NOBIC-NTU/NOBIC-SCELSE-Preamplifier/README.md

# NOBIC-SCELSE-Preamplifier
Public repository for fixed gain transimpedance amplifier circuit for two-photon microscopes
