NOBIC-NTU/NOBIC-SCELSE-Preamplifier/Bill of Materials/Final Bill of Materials v1r4 Assembly exclude active components.xlsx

Designator | Footprint | LibRef | Desc | Cmmt | Pins | THT(y/n) | Tolerance | Rating | Value | Quantity | Manufacturer | Manufacturer Part No
C1, C3 | RES-0603 | - CAP-NON | SMT Chip Capacitor | - | 2 | N | 10% | 20V | 1uF | 1 | Samsung Electro-Mechanics | CL10B105KA8NFNC (https://www.mouser.sg/ProductDetail/Samsung-Electro-Mechanics/CL10B105KA8NFNC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)
C2, C5 | CAP-0603 | - CAP-NON | SMT Chip Capacitor | - | 2 | N | 20% | 10V | 22uF | 2 | Murata | GRM188R61A226ME15D (https://www.mouser.sg/ProductDetail/Murata-Electronics/GRM188R61A226ME15D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)
C4 | RES-0603 | - CAP-NON | SMT Chip Capacitor | - | 2 | N | 10% | 16V | 4.7uF | 1 | Samsung Electro-Mechanics | CL10A475MO8NNNC (https://www.mouser.sg/ProductDetail/Samsung-Electro-Mechanics/CL10A475MO8NNNC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)
C6, C15 | CAP-0603 | - CAP-NON | Multilayer Ceramic Capacitors MLCC - SMD/SMT | - | 2 | N | ±0.1pF | 50V | 0.75pF | 2 | Walsin | RF18NR75B500CT (https://www.mouser.sg/ProductDetail/Walsin/RF18NR75B500CT?qs=hzBznG4dWXWSuJqhmXrjQw%3D%3D)
C7, C16 | CAP-0603 | - CAP-NON | Multilayer Ceramic Capacitors MLCC - SMD/SMT | - | 2 | N | ±1% | 100V | 13pF | 2 | Murata | GCM1885C2A130FA16J (https://www.mouser.sg/ProductDetail/Murata-Electronics/GCM1885C2A130FA16J?qs=QzBtWTOodeVdB%252BMy5RRu7A%3D%3D)
C8, C10, C17, C19, C9, C11, C18, C20 | RES-0603 | - CAP-NON | SMT Chip Capacitor | - | 2 | N | 5% | 10V | 0.1uF | 8 | Samsung Electro-Mechanics | CL10B104JB8NNNC (https://www.mouser.sg/ProductDetail/Samsung-Electro-Mechanics/CL10B104JB8NNNC?qs=349EhDEZ59oLEw5wc1qvGw%3D%3D)
C12, C13, C14, C21, C22, C23 | CAP-0603 | - CAP-NON | Multilayer Ceramic Capacitors MLCC - SMD/SMT | DNP | 2 | N | ±1% | 25V |  | 6
CNR2, CNR4, CNR6, CNR8 | SMA_EDGE | SMA | RF Connectors / Coaxial Connectors SMA PCB MOUNT JACK | DNP | 2 |  |  |  |  | 4 | Taoglas | EMPCB.SMAFSTJ.C.HT (https://www.mouser.sg/ProductDetail/Taoglas/EMPCB.SMAFSTJ.C.HT?qs=AL7xPqYNrmS49k5WLHoXWA%3D%3D)
CP1 | SME8x10.5-2.2E [E] | - CAP-POL | Aluminium Electrolytic Capacitors - SMD 63 Volts 10uF | - | 2 | N | 20% | 20V | 10uF | 1 | United Chemi-Con | EMVH630ADA100MH63G (https://www.mouser.sg/ProductDetail/United-Chemi-Con/EMVH630ADA100MH63G?qs=pW%2FnNqOvN%2FD4nZo4A7r8EQ%3D%3D)
D1 | SOD123 | - DIO-ZNR | Schottky Diodes & Rectifiers REC SPCL SKTKY | - | 2 | N | - | 0.5A | 20 V | 1 | onsemi | SBR80520LT1G (https://www.mouser.sg/ProductDetail/onsemi/SBR80520LT1G?qs=VZpK7o2ExSQ%252BUJtVfeZ3AQ%3D%3D)
FB1, FB2, FB3, FB4, FB5, FB6 | IND-0603 | - IND | Ferrite Beads 60 OHM 25% | - | 2 | N | 25% | 0.6A | 60 Ohms @ 100MHz | 6 | Murata | BLM18BB600SN1D (https://www.mouser.sg/ProductDetail/Murata-Electronics/BLM18BB600SN1D?qs=O%252B3PzI9Hd0PHjaZtQ%252BJmbQ%3D%3D)
FB3, FB4, FB5, FB6 | IND-0603 | - IND | 0 ohm Jumpers | DNP | 2 | N | 25% | 0.6A | 0R | 0 | Vishay | CRCW06030000Z0EBC (https://www.mouser.sg/ProductDetail/Vishay-Dale/CRCW06030000Z0EBC?qs=wd5RIQLrsJgQzOqdcVum5Q%3D%3D)
L1, L2 | IND-0805[NL] | - IND | Fixed Inductors 0805 4.7uH .265Ohms +/-20%Tol 700mA | - | 2 | N | 20% | 500mA | 4.7uH | 2 | Taiyo Yuden | BRC2012T4R7MD (https://www.mouser.sg/ProductDetail/Taiyo-Yuden/BRC2012T4R7MD?qs=I6KAKw0tg2xBb7myNzjo4A%3D%3D)
R1, R7 | RES-0603 | - RES-FIX | Thick Film Resistors - SMD 28.7K ohm 1% | - | 2 | N | ±1% | 50V | 28.7K | 2 | Bourns | CR0603-FX-2872ELF (https://www.mouser.sg/ProductDetail/Bourns/CR0603-FX-2872ELF?qs=I4suiNu8FYAnWpr1IIimOQ%3D%3D)
R2, R8 | RES-0603 | - RES-FIX | Thick Film Resistors - SMD 287Ohms 1/10W 0603 1% AEC-Q200 | - | 2 | N | ±1% | 50V | 287R | 2 | Yageo | AC0603FR-07287RL (https://www.mouser.sg/ProductDetail/YAGEO/AC0603FR-07287RL?qs=ygRr%2FtkhteusAISpE4WOKw%3D%3D)
R3, R5, R6, R9, R11, R12 | RES-0603 | - RES-FIX | - | DNP | 2 | N | ±1% | 50V |  | 6
R4, R10 | RES-0603 | - RES-FIX | Thick Film Resistors - SMD 33 Ohms 100mW 0603 1% | - | 2 | N | ±1% | 50V | 33R | 2 | Yageo | RC0603FR-0733RL (https://www.mouser.sg/ProductDetail/YAGEO/RC0603FR-0733RL?qs=diQw95jMAeMotgif2GSHTQ%3D%3D)
R13 | RES-0603 | - RES-FIX | Thin Film Resistors 9.88kOhm,0603,0.1%,25ppm,125mW,75V | - | 2 | N | ±0.1% | 75V | 9.88k | 1 | Vishay | TNPW06039K88BEEA (https://www.mouser.sg/ProductDetail/Vishay-Dale/TNPW06039K88BEEA?qs=xRzy8zN3RW08B1d9kgF3Jg%3D%3D)
R14 | RES-0603 | - RES-FIX | Thin Film Resistors - SMD 10K ohm 0.5% 1/10W | - | 2 | N | ±1% | 50V | 10k | 1 | YAGEO | RT0603DRE0710KL (https://www.mouser.sg/ProductDetail/YAGEO/RT0603DRE0710KL?qs=8cPjvKtxWv4b6IDhFsneiQ%3D%3D)
TVS1, TVS2 | SOD923F | - TVS-UNI | ESD Suppressors / TVS Diodes SOD-923 ESD PROT | - | 2 | N | - | 140W | 12V | 2 | onsemi | ESD9X12ST5G (https://www.mouser.sg/ProductDetail/onsemi/ESD9X12ST5G?qs=OSf9jACorvYeEtLjAfCdrQ%3D%3D)
U1 | SOT223 | > ICS: LDL1117SxxR | LDO Voltage Regulators 1.2 A High PSRR low dropout linear voltage regulator | DNP | 4 | N | - | - | - | 1 | STMicroelectronics | LDL1117S25R (https://www.mouser.sg/ProductDetail/STMicroelectronics/LDL1117S25R?qs=AQlKX63v8Rvz10Qjkk6upg%3D%3D)
U2 | SOT95P280X145-5N | REG: LT1611CS5#TRMPBF | Switching Voltage Regulators 1.4MHz Inverting Sw Reg. | DNP | 5 | N | - | - | - | 1 | Analog Devices | LT1611CS5#TRMPBF (https://www.mouser.sg/ProductDetail/Analog-Devices/LT1611CS5TRMPBF?qs=ytflclh7QUWyKl6o%2Fr0zng%3D%3D)
U3, U4 | SON50P300X300X80-11N-D | > ICS: LTC6269IDD#PBF | 500MHz Ultra-Low Bias Current FET Input Op Amp | DNP | 11 | N | - | - | - | 2 | AD | LTC6269IDD#PBF (https://www.mouser.sg/ProductDetail/Analog-Devices/LTC6269IDDPBF?qs=hVkxg5c3xu8tgdvxZL9h5w%3D%3D)
CNR1, 3, 5, 7, 9 |  |  | Headers & Wire Housings 2mm Pitch WtoB Conn 2pos Straight Header | DNP | 2 | Y |  |  |  | 5 | Hirose | DF51K-2P-2DSA(800) (https://www.mouser.sg/ProductDetail/Hirose-Connector/DF51K-2P-2DSA800?qs=T3oQrply3y%2FMgopKRZYGOg%3D%3D)
