NOBIC-NTU/NOBIC-SCELSE-Preamplifier/3D Models/Board dimensions and Hirose conns No components/TIA_v1r4_July2022_VerticalConns_FlipPWR.stp

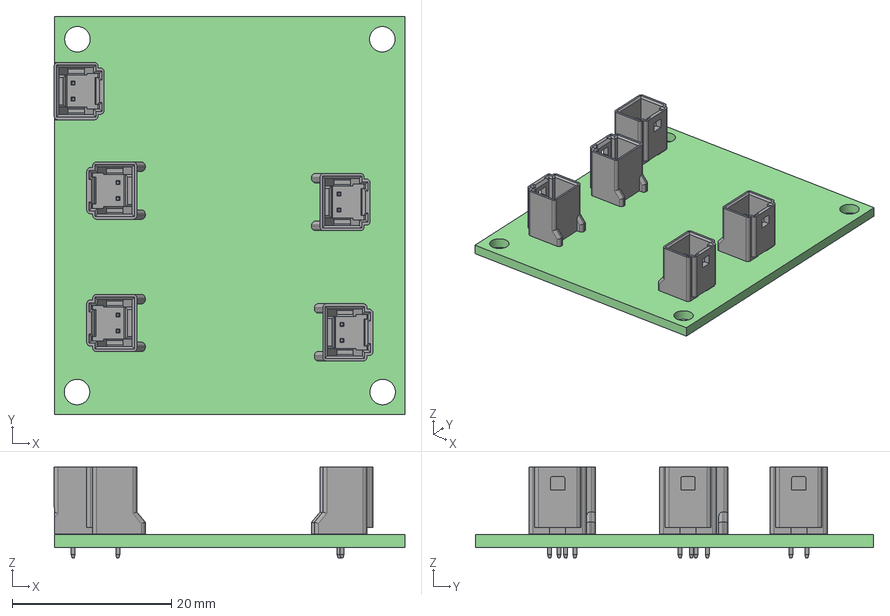
[picture p10: CAD file, 2023-02-13]
3D Models/Board dimensions and Hirose conns No components/TIA_v1r4_July2022_VerticalConns_FlipPWR.stp
44.0 x 50.0 x 11.4 mm
_autosave-TIA_v1r4_July2022 PCB
