NOBIC-NTU/NOBIC-SCELSE-Preamplifier/3D Models/v1r3 - SMA conns/preamp_v1r3.step

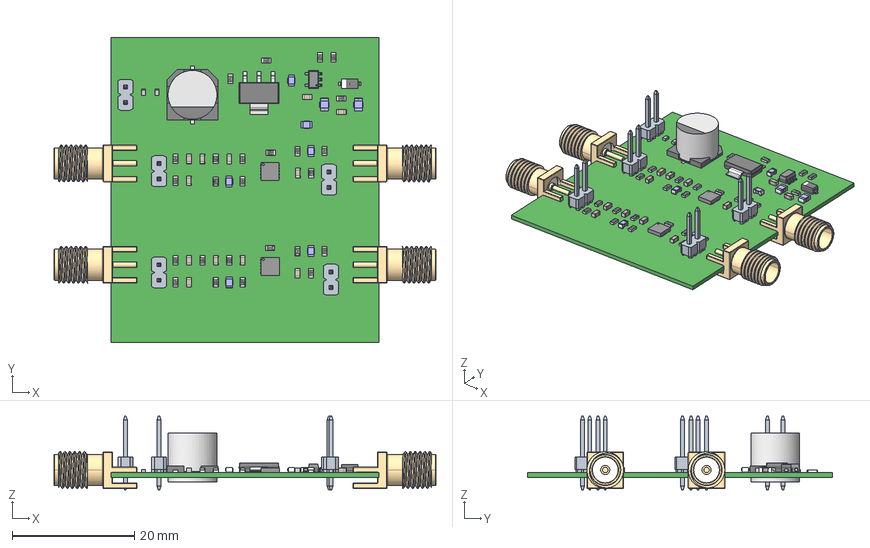
[picture p11: CAD file, 2023-02-13]
3D Models/v1r3 - SMA conns/preamp_v1r3.step
62.6 x 50.0 x 12.1 mm
ThermalPin x 2
PinsArrayLR x 2
PinsArrayL
PinsArrayR
RES-0603 x 25
INDUC-0805 x 2
SOD123
Open_CASCADE_STEP_translator_6.8_13.1.1
Lead x 3
Tab
SOD923F x 2
INDUC-0603 x 6
Open_CASCADE_STEP_translator_6.8_8.1.1
Open_CASCADE_STEP_translator_6.8_8.2.1
Open_CASCADE_STEP_translator_6.8_8.2.2
Open_CASCADE_STEP_translator_6.8_8.3.1
lead x 2
User_Library-620-SMA-02-112-TGG_SMA_Female_for_PCB_edge_Mount x 4
CAP-0603 x 12
