NOBIC-NTU/NOBIC-SCELSE-Preamplifier/PCB dimensions and stackup/Draftsman.PDF

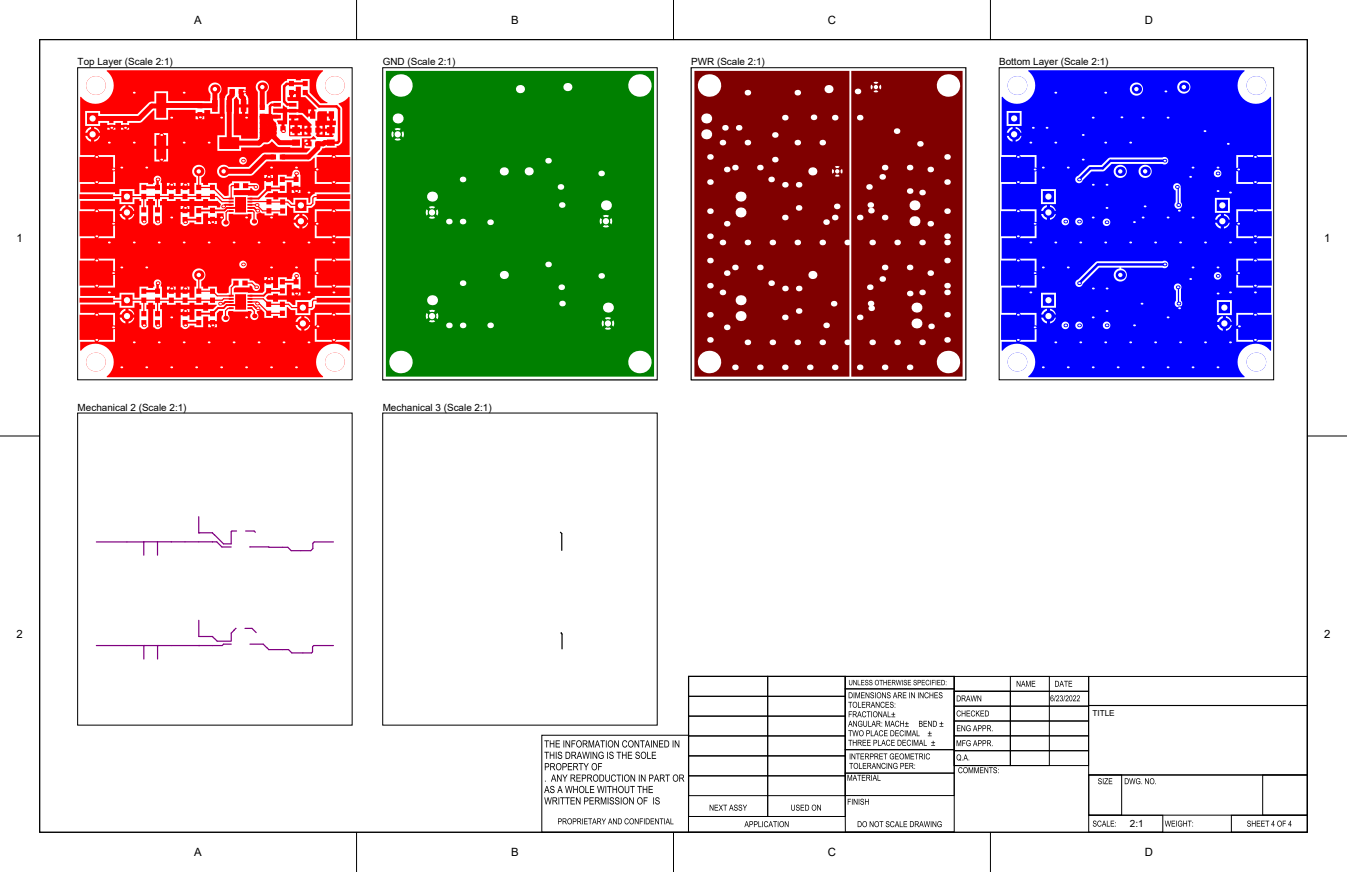
[picture p16: page 4]
