NOBIC-NTU/NOBIC-SCELSE-Preamplifier/Schematic Diagram/preamp_v1r4 SCH.PDF

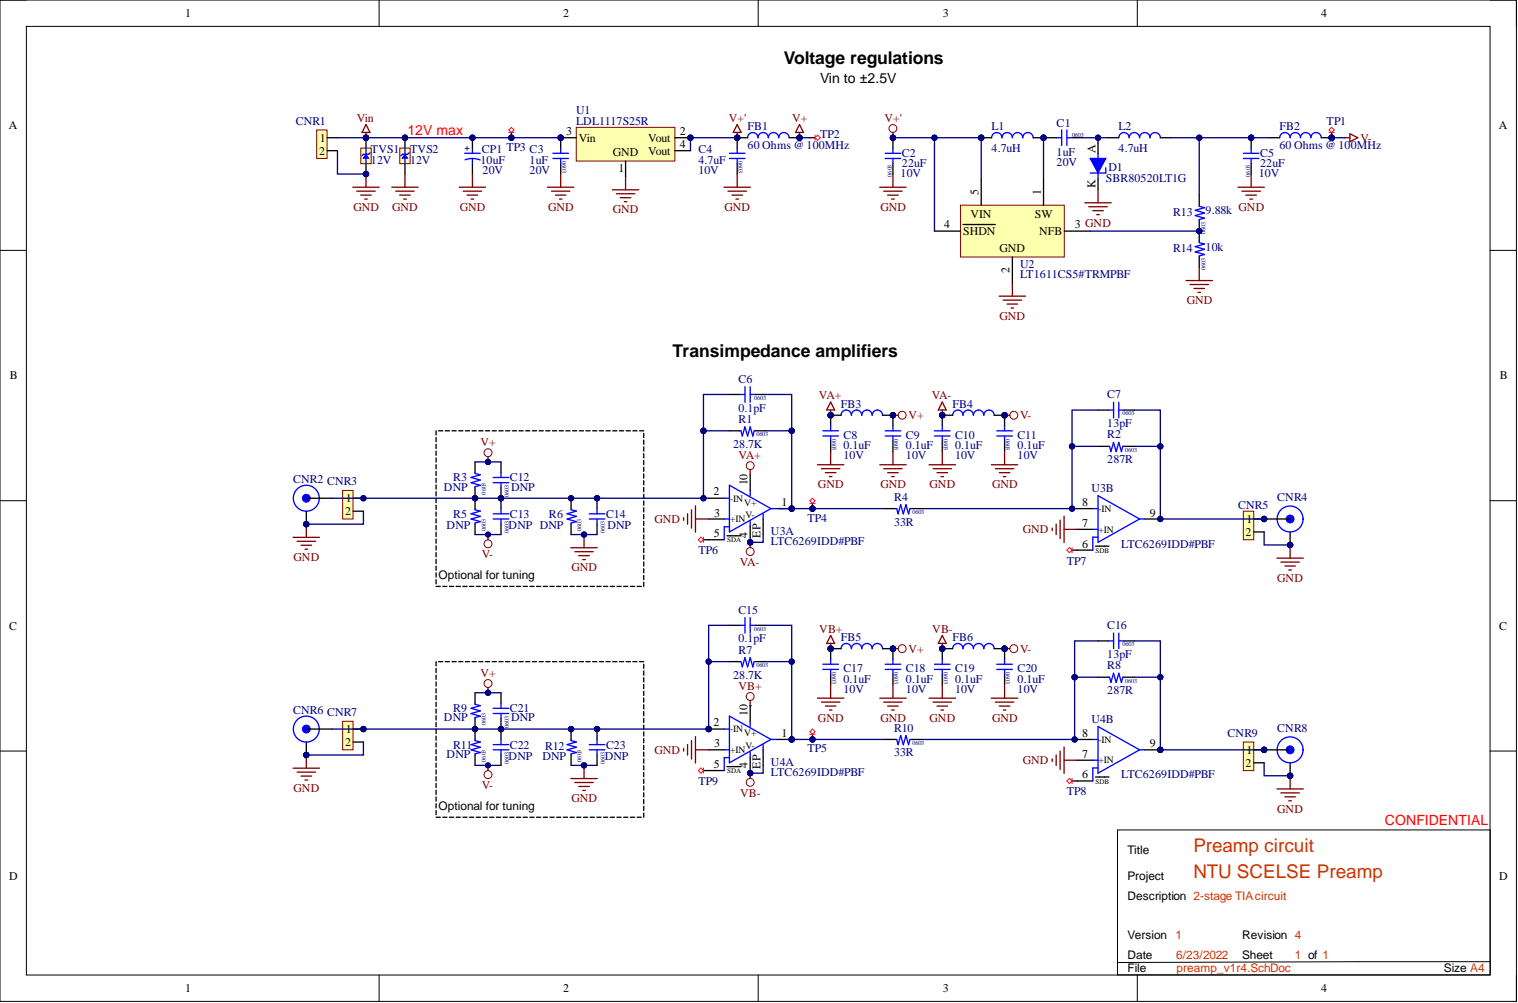
[picture p12: page 1]

GND Optional for tuning
