NOBIC-NTU/NOBIC-SCELSE-Preamplifier/PCB dimensions and stackup/Draftsman.PDF

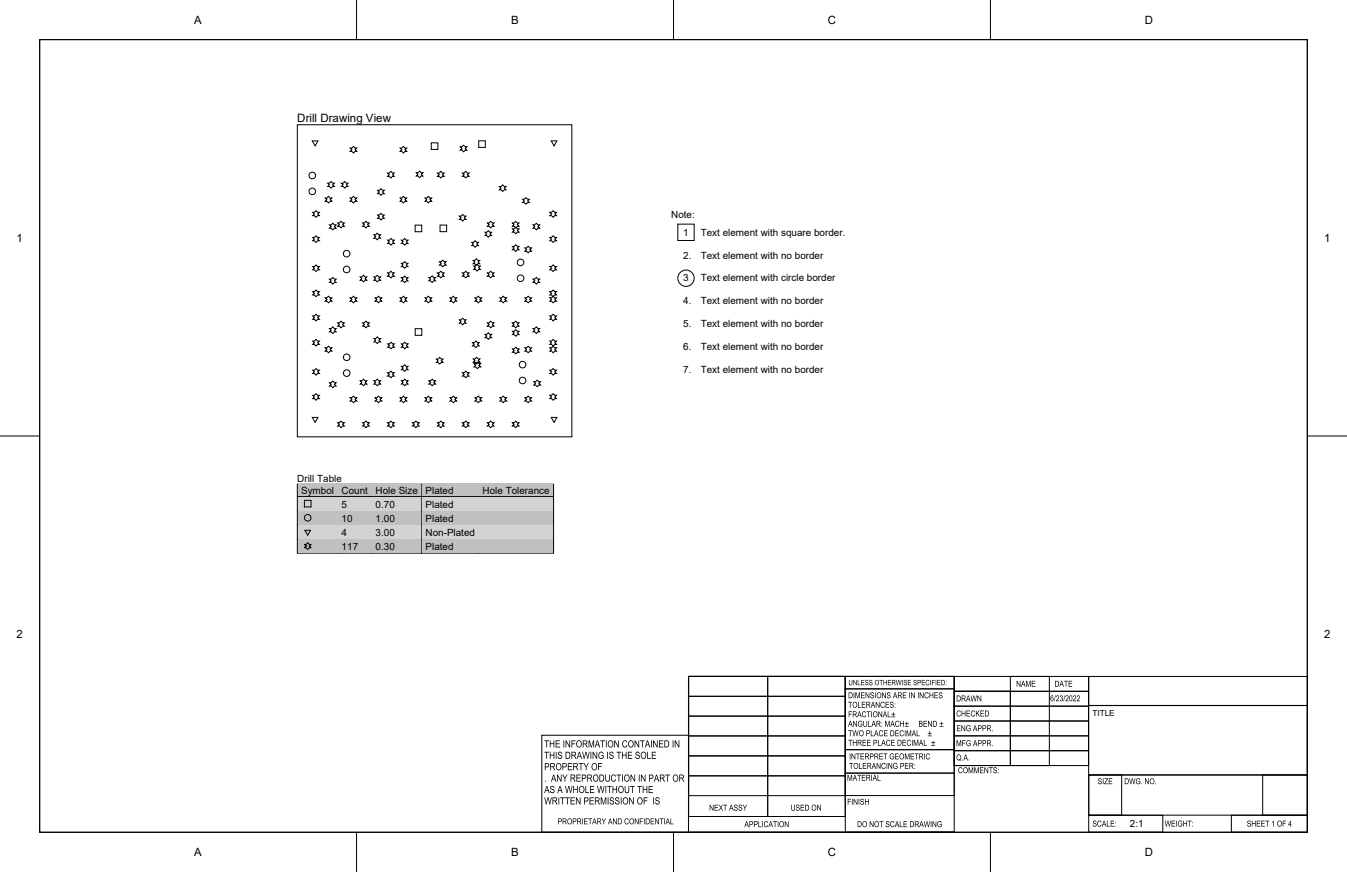
[picture p13: page 1]

2. Text element with no border

3 Text element with circle border

4. Text element with no border

5. Text element with no border

6. Text element with no border

7. Text element with no border

Symbol | Count | Hole Size | Plated | Hole Tolerance

5 | 0.70 | Plated
10 | 1.00 | Plated
4 | 3.00 | Non-Plated
117 | 0.30 | Plated

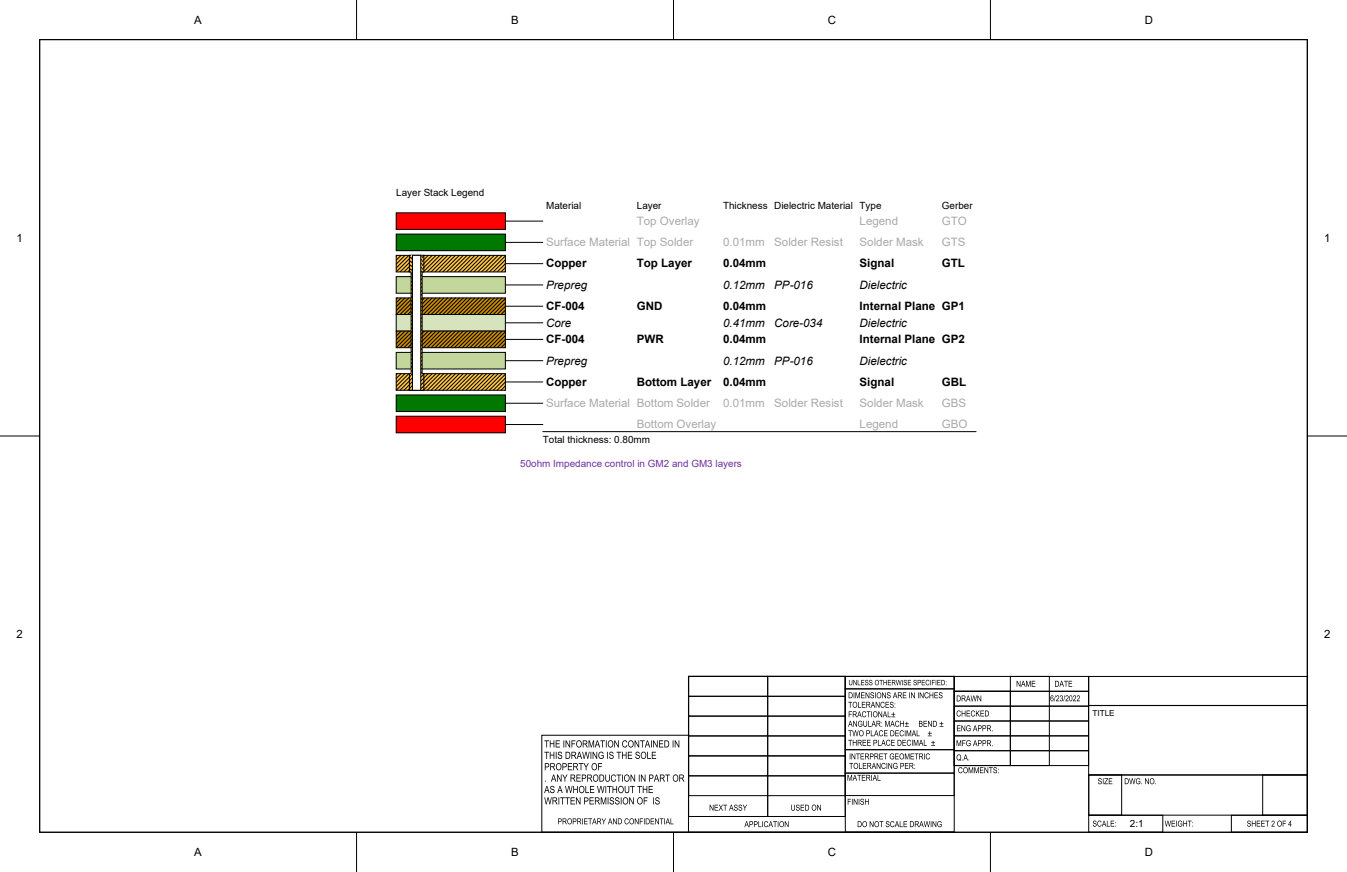
[picture p14: page 2]

50ohm Impedance control in GM2 and GM3 layers

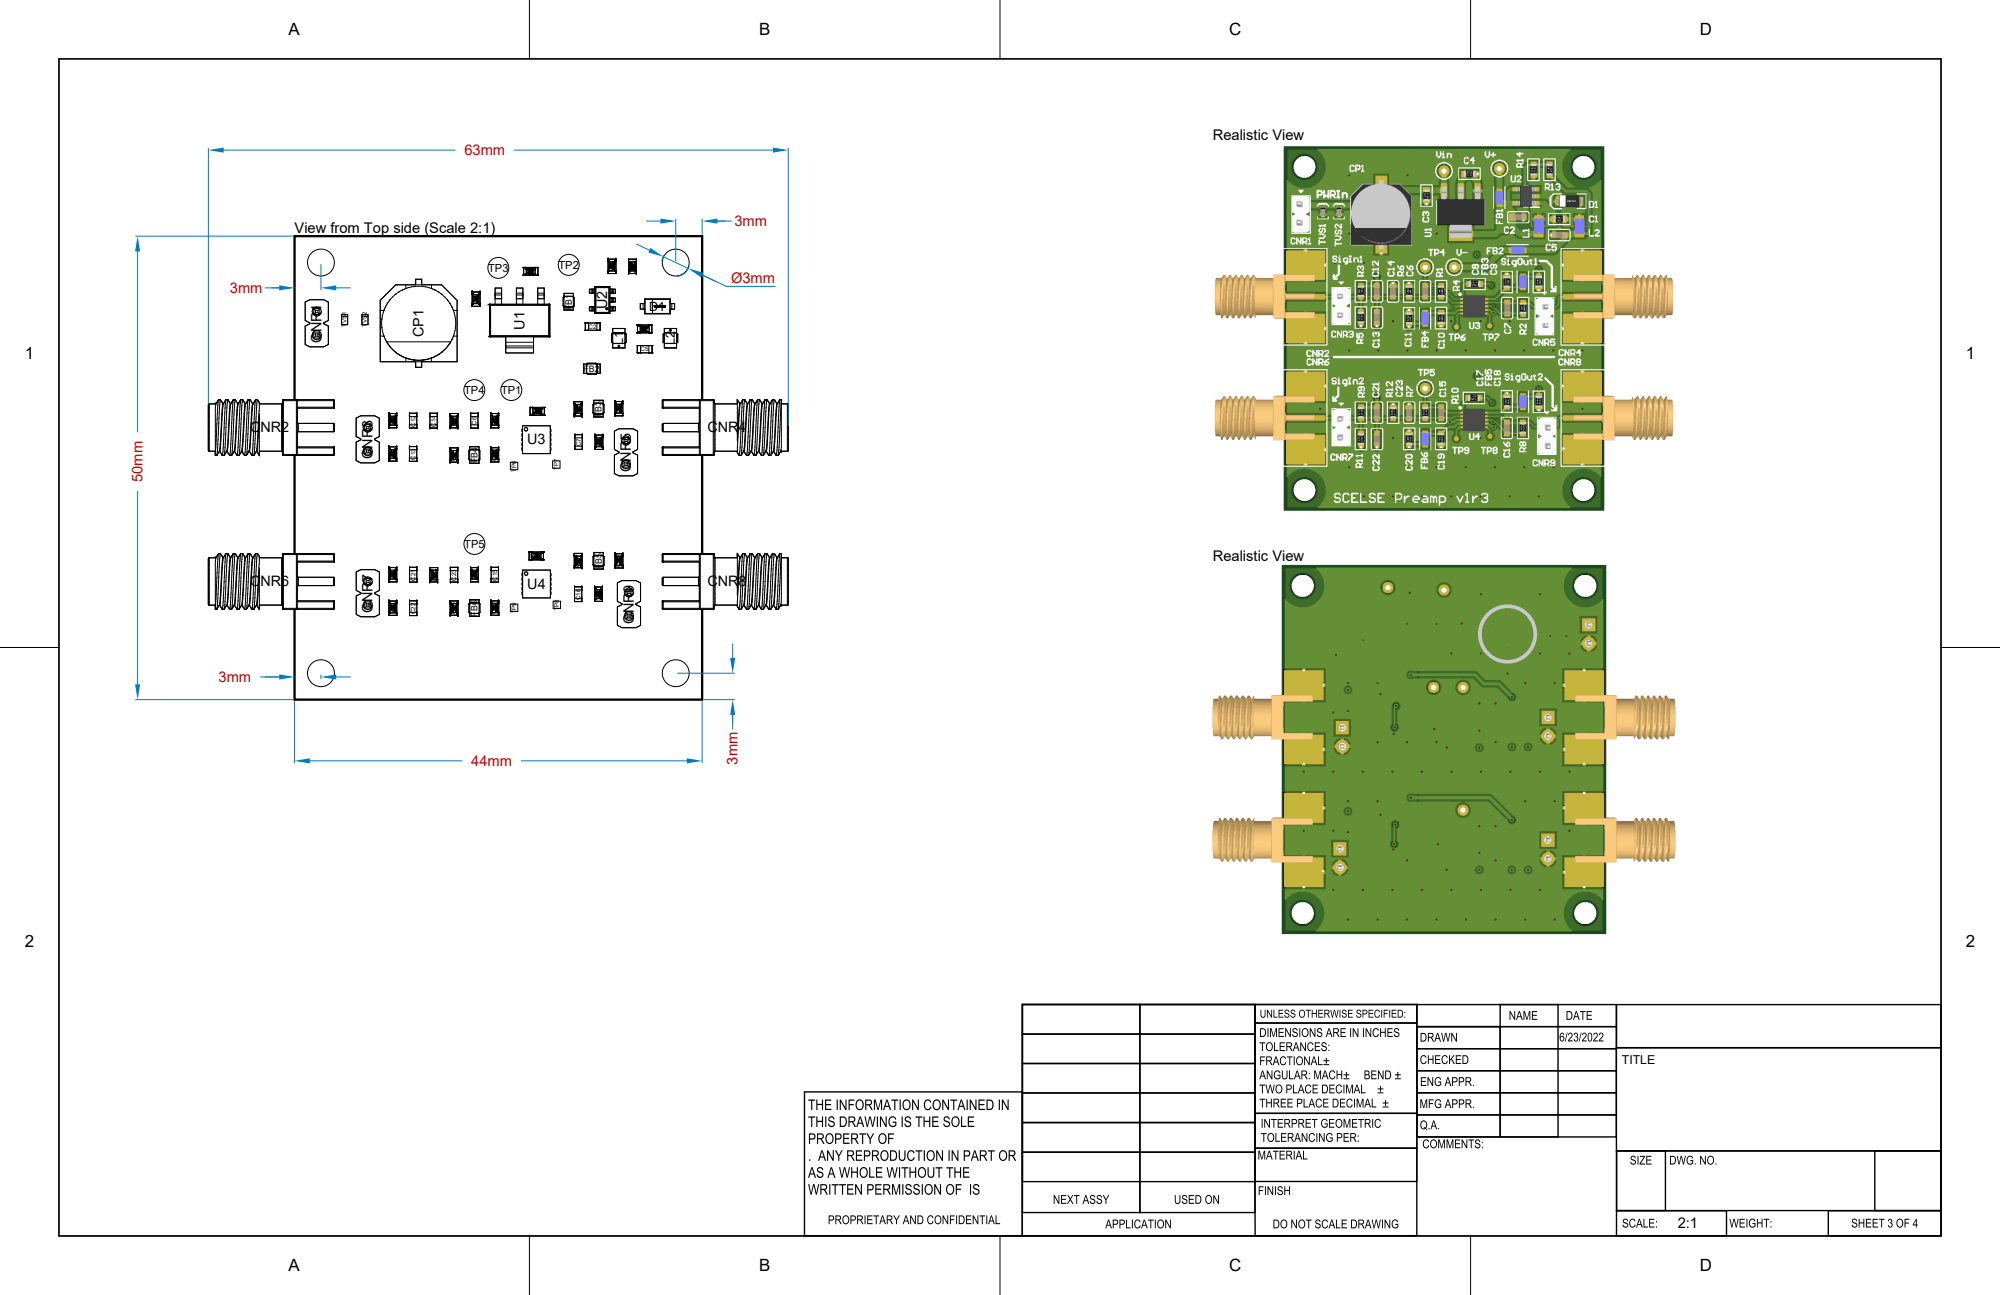
[picture p15: page 3]

View from Top side (Scale 2:1)
